HeronMkII/coms-ssm/(list of files, drawings)

Other design files:
coms_ssm.dsn
