HeronMkII/coms-ssm/coms_ssm.kicad_pcb

## KiCad design coms_ssm.kicad_pcb (2017-08-09)

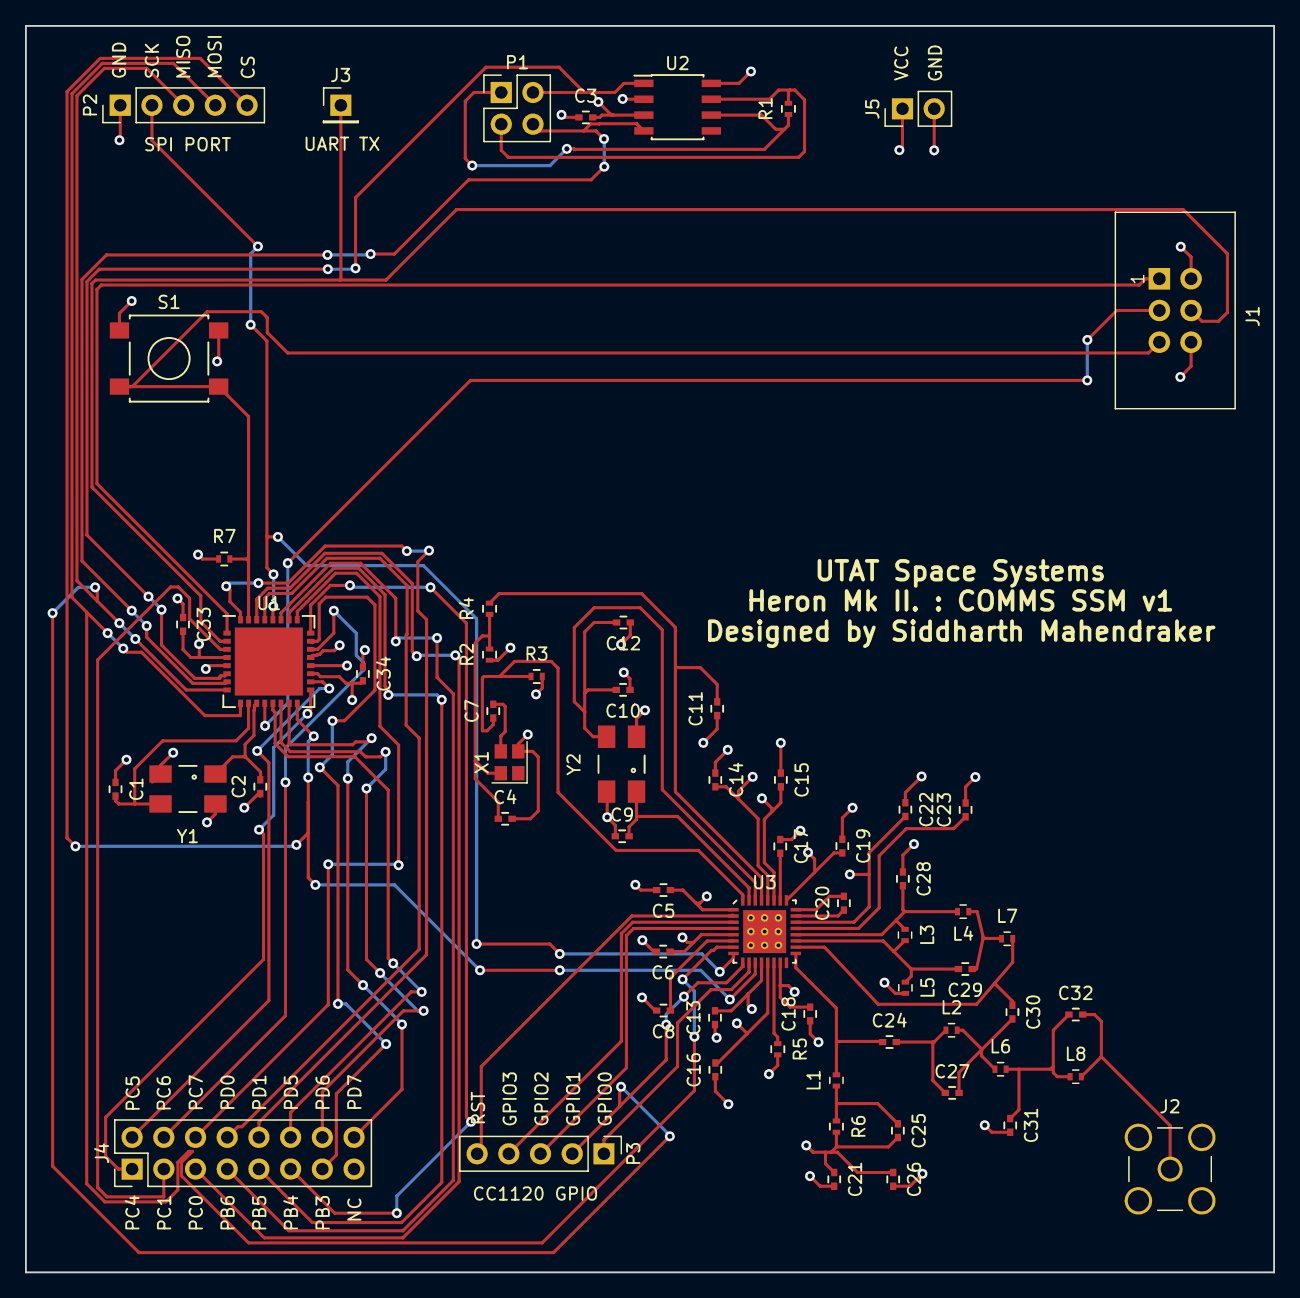
[picture p1: board coms_ssm.kicad_pcb from above]

Board: 4 copper layers, 100.0 x 99.9 mm, 64 parts (0 on the bottom side), 57 nets.

Parts:
C1, C2, C7: 22pF; C_0402
C3: 1uF; C_0402
C4, C33, C34: 100nF; C_0402
C5, C6, C11, C13, C14, C15, C16, C17, C18, C19, C22: 47nF; C_0402
C8: 220nF; C_0402
C9, C10: 15pF; C_0402
C12, C32: C_Small; C_0402
C20: 1.8nF; C_0402
C21, C23: 10nF; C_0402
C24: 39pF; C_0402
C25: 56pF; C_0402
C26: 100pF; C_0402
C27: 2.2pF; C_0402
C28, C29, C30: 5.1pF; C_0402
C31: 6.2pF; C_0402
J1: PROGRAMMING PORT; IDC_Header_Straight_6pins
J2: CONN_COAXIAL; SMA_THT_Jack_Straight
J3: UART TX; Pin_Header_Straight_1x01_Pitch2.54mm
J4: CONN_02X08; Pin_Header_Straight_2x08_Pitch2.54mm
J5: POWER; Pin_Header_Straight_1x02_Pitch2.54mm
L1, L3: 56nH; L_0402
L2, L7: 15nH; L_0402
L4: 27nH; L_0402
L5: 27nF; L_0402
L6: 43nH; L_0402
L8: 22nH; L_0402
P1: CAN PORT; Pin_Header_Straight_2x02_Pitch2.54mm
P2: SPI PORT; Pin_Header_Straight_1x05_Pitch2.54mm
P3: CC1120 IO PINS; Pin_Header_Straight_1x05_Pitch2.54mm
R1: 120; R_0402
R2, R3: 0; R_0402
R4: R; R_0402
R5: 56K; R_0402
R6: 18; R_0402
R7: 10K; R_0402
S1: SPST; SW_SPST_B3S-1000
U1: ATMEGA32M1-MU; QFN-32-1EP_7x7mm_Pitch0.65mm
U2: SN65HVD233D; SOIC-8_3.9x4.9mm_Pitch1.27mm
U3: CC1120; cc1120
X1: TG_5021CG; Crystal_SMD_2520-4pin_2.5x2.0mm
Y1, Y2: Crystal_GND24; Crystal_SMD_0603_4Pads

Connections:
+3V3: C3.2, C5.1, C6.1, C13.2, C14.2, C15.2, C16.2, C18.2, C19.2, C21.1, C22.2, C25.2, C26.1, C33.2, C34.2, J1.2, J5.1, R2.1, R6.2, R7.1, U1.4, U1.19, U1.21, U2.3, U3.1, U3.5, U3.12, U3.13, U3.15, U3.22, U3.25, U3.27, U3.28
/CANH: P1.3, R1.2, U2.7
/CANL: P1.1, R1.1, U2.6
/CS: P2.5, U1.16, U3.11
/GPIO0: P3.1, U3.10
/GPIO1: P2.3, P3.2, U1.8, U3.9
/GPIO2: P3.3, U3.4
/GPIO3: P3.4, U3.3
/MISO_A: J1.1, U1.1
/MOSI: P2.4, U1.9, U3.7
/MOSI_A: J1.4, J3.1, U1.2
/PB3: J4.13, U1.23
/PB4: J4.11, U1.24
/PB5: J4.9, U1.26
/PB6: J4.7, U1.27
/PC0: J4.5, U1.30
/PC1: J4.3, U1.3
/PC4: J4.1, U1.17
/PC5: J4.2, U1.18
/PC6: J4.4, U1.22
/PC7: J4.6, U1.25
/PD0: J4.8, U1.29
/PD1: J4.10, U1.32
/PD5: J4.12, U1.13
/PD6: J4.14, U1.14
/PD7: J4.16, U1.15
/RESET: J1.5, R7.2, S1.2, U1.31
/RESET_N: P3.5, U3.2
/RX_CAN: P1.4, U1.7, U2.4
/SCK: P2.2, U1.28, U3.8
/SCK_A: J1.3, U1.12
/TX_CAN: P1.2, U1.6, U2.1
GND: C1.1, C2.1, C3.1, C4.2, C5.2, C6.2, C8.2, C9.1, C10.1, C11.1, C12.1, C13.1, C14.1, C15.1, C16.1, C17.1, C18.1, C19.1, C21.2, C22.1, C23.2, C26.2, C28.1, C31.2, C33.1, C34.1, J1.6, J5.2, L5.2, P2.1, R3.2, R5.2, S1.1, U1.5, U1.20, U2.2, U2.8, U3.33, X1.2, Y1.2, Y1.4, Y2.2, Y2.4
unnamed: C1.2, U1.10, Y1.3
unnamed: C2.2, U1.11, Y1.1
unnamed: C4.1, R2.2, R4.1, X1.4
unnamed: C7.1, R3.1, U3.32
unnamed: C7.2, X1.3
unnamed: C8.1, U3.6
unnamed: C9.2, U3.31, Y2.1
unnamed: C10.2, C12.2, U3.30, Y2.3
unnamed: C11.2, R4.2, U3.29
unnamed: C17.2, U3.26
unnamed: C20.1, U3.23
unnamed: C20.2, U3.24
unnamed: C23.1, U3.21
unnamed: C24.1, L1.2, U3.17
unnamed: C24.2, C27.1, L2.1
unnamed: C25.1, L1.1, R6.1
unnamed: C27.2, C30.2, L2.2, L6.1
unnamed: C28.2, L3.1, L4.2, U3.20
unnamed: C29.1, L4.1, L7.1
unnamed: C29.2, L3.2, L5.1, U3.19
unnamed: C30.1, L7.2, U3.18
unnamed: C31.1, C32.1, L6.2, L8.1
unnamed: C32.2, J2.1, L8.2
unnamed: R5.1, U3.14
